Jaystonian/ClearVideo/vic20-svideoLHM/pics/vic20-svideoLHM.png

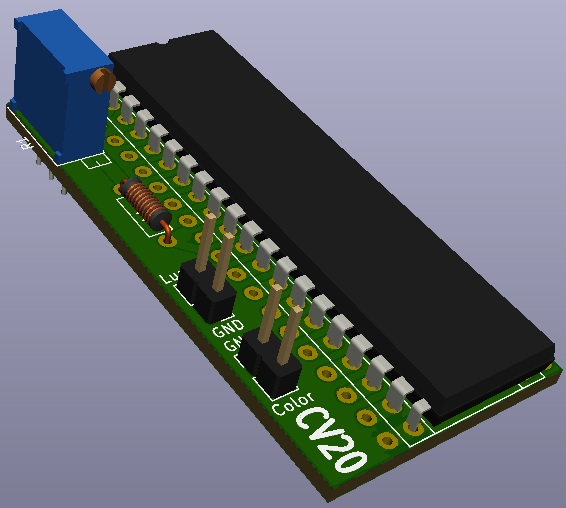
vic20-svideoLHM/pics/vic20-svideoLHM.png
