Jaystonian/ClearVideo/vic20-svideoLHM/pics/IMG_20200324_195534_3.jpg

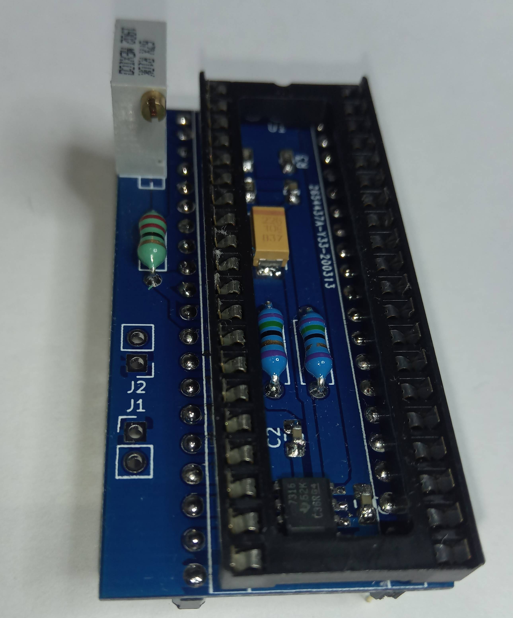
vic20-svideoLHM/pics/IMG_20200324_195534_3.jpg
