Jaystonian/ClearVideo/README.md

# ClearVideo
Various S-Video devices

2020-10-04 
 * Updated the schematics and pcb to show I am using a 74F04, not a 74F06.. It has always been a '04.
 * Updated CV128 layout slightly.
