Jaystonian/ClearVideo/clearvideo128/clearvideo128.jpg

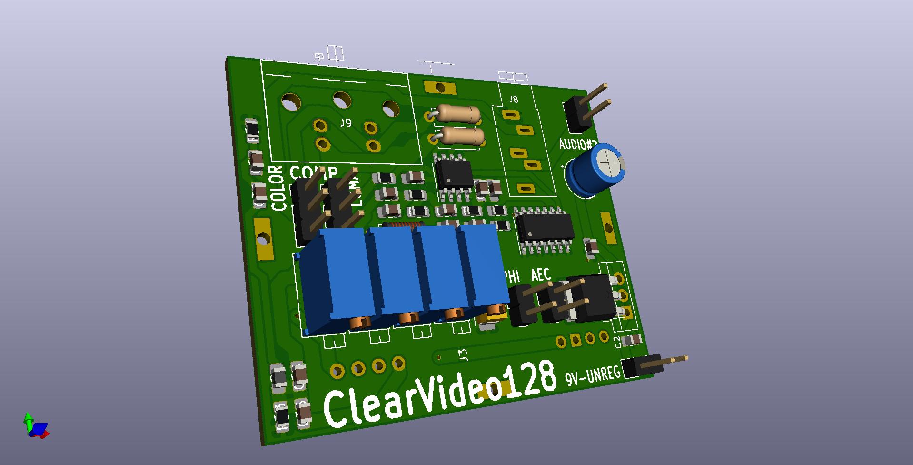
clearvideo128/clearvideo128.jpg
