Jaystonian/ClearVideo/vic20-svideoLHM/pics/IMG_20200324_195540_5.jpg

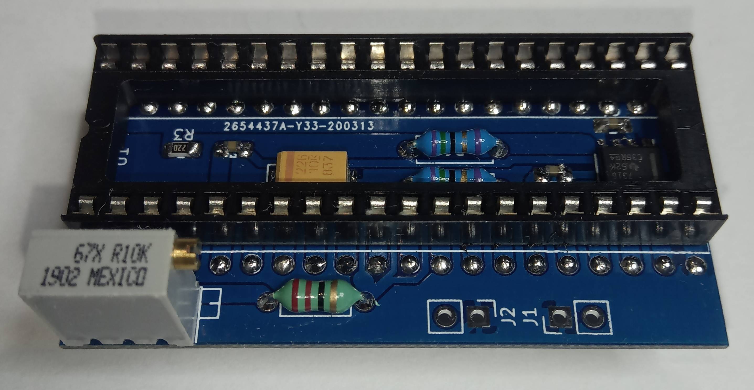
vic20-svideoLHM/pics/IMG_20200324_195540_5.jpg
