Jaystonian/ClearVideo/vic20-svideoLHM/pics/inst1.jpg

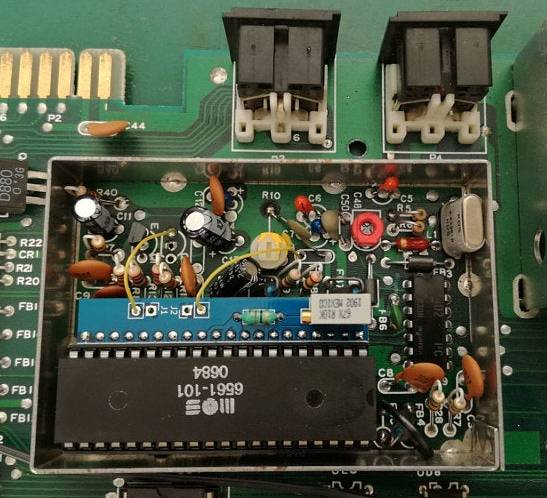
vic20-svideoLHM/pics/inst1.jpg
