Jaystonian/ClearVideo/vic20-svideoLHM/pics/inst2.jpg

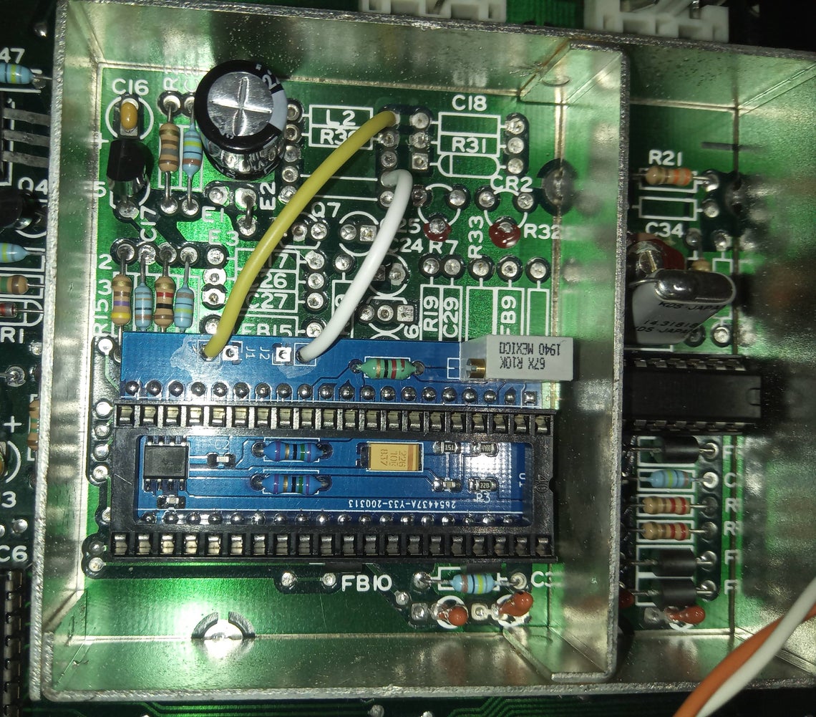
vic20-svideoLHM/pics/inst2.jpg
