Jaystonian/ClearVideo/vic20-svideoLHM/bom.txt

Most SMD are 2012 metric
22uF SMD is 6032 Kemet 

75.0R	0.302	2	r4,r7
THS7316D	0.852	1	u1
74LVC06	0.255	1	u2

R2	22R
R6	150R
R13	2K
R15	2K
R8	2K
R14	250R
R9	250R
R10	470R
R3	5K6

R16	250R
R1	10K

L1	22uH

C1	330pF
C2	150pF
C3	0.1uF
C4	0.1uF
C5	0.1uF
C6	47pF
C7	47pF
C8	22uF
C9	0.1uF
C11	47pF
