Jaystonian/ClearVideo/clearvideo128/clearvideo128.pdf

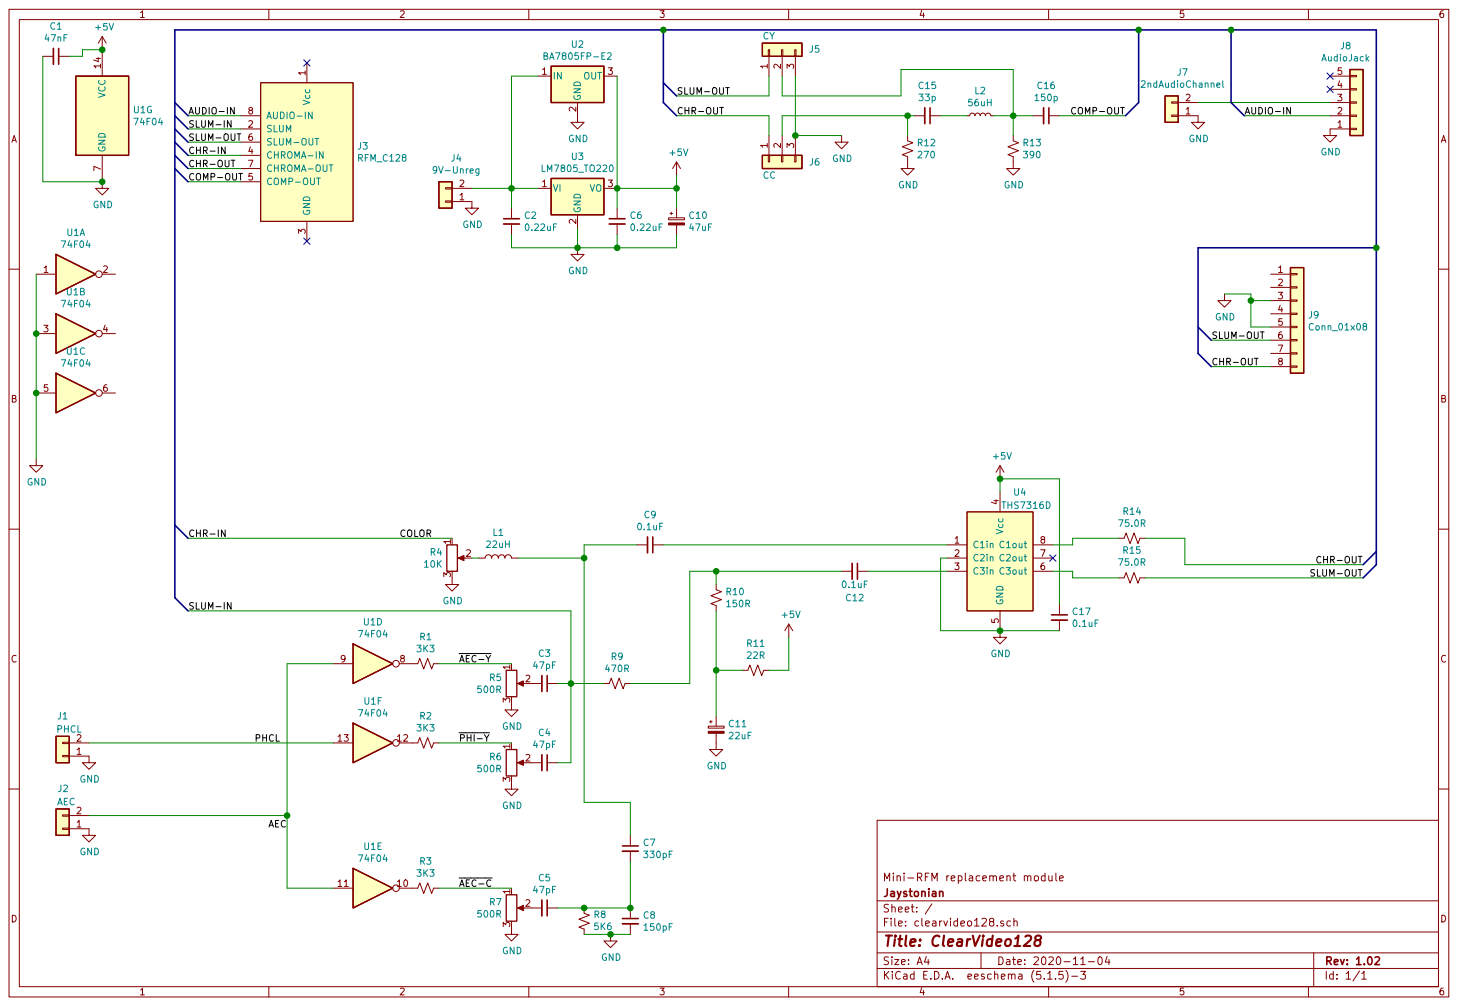
[picture p7: page 1]

SLUM-IN
SLUM-OUT CHR-IN
74F04 GND

3 CHROMA-IN 4 COMP-OUT 5 SLUM-OUT 6 CHROMA-OUT 7 AUDIO-IN 8

CHR-OUT PHCL AEC

CHR-OUT SLUM-OUT AEC-Y

Mini-RFM replacement module R8

File: clearvideo128.sch Sheet: / Jaystonian
