Jaystonian/ClearVideo/clearvideo128/clearvideo128.kicad_pcb

## KiCad design clearvideo128/clearvideo128.kicad_pcb (2020-10-06)

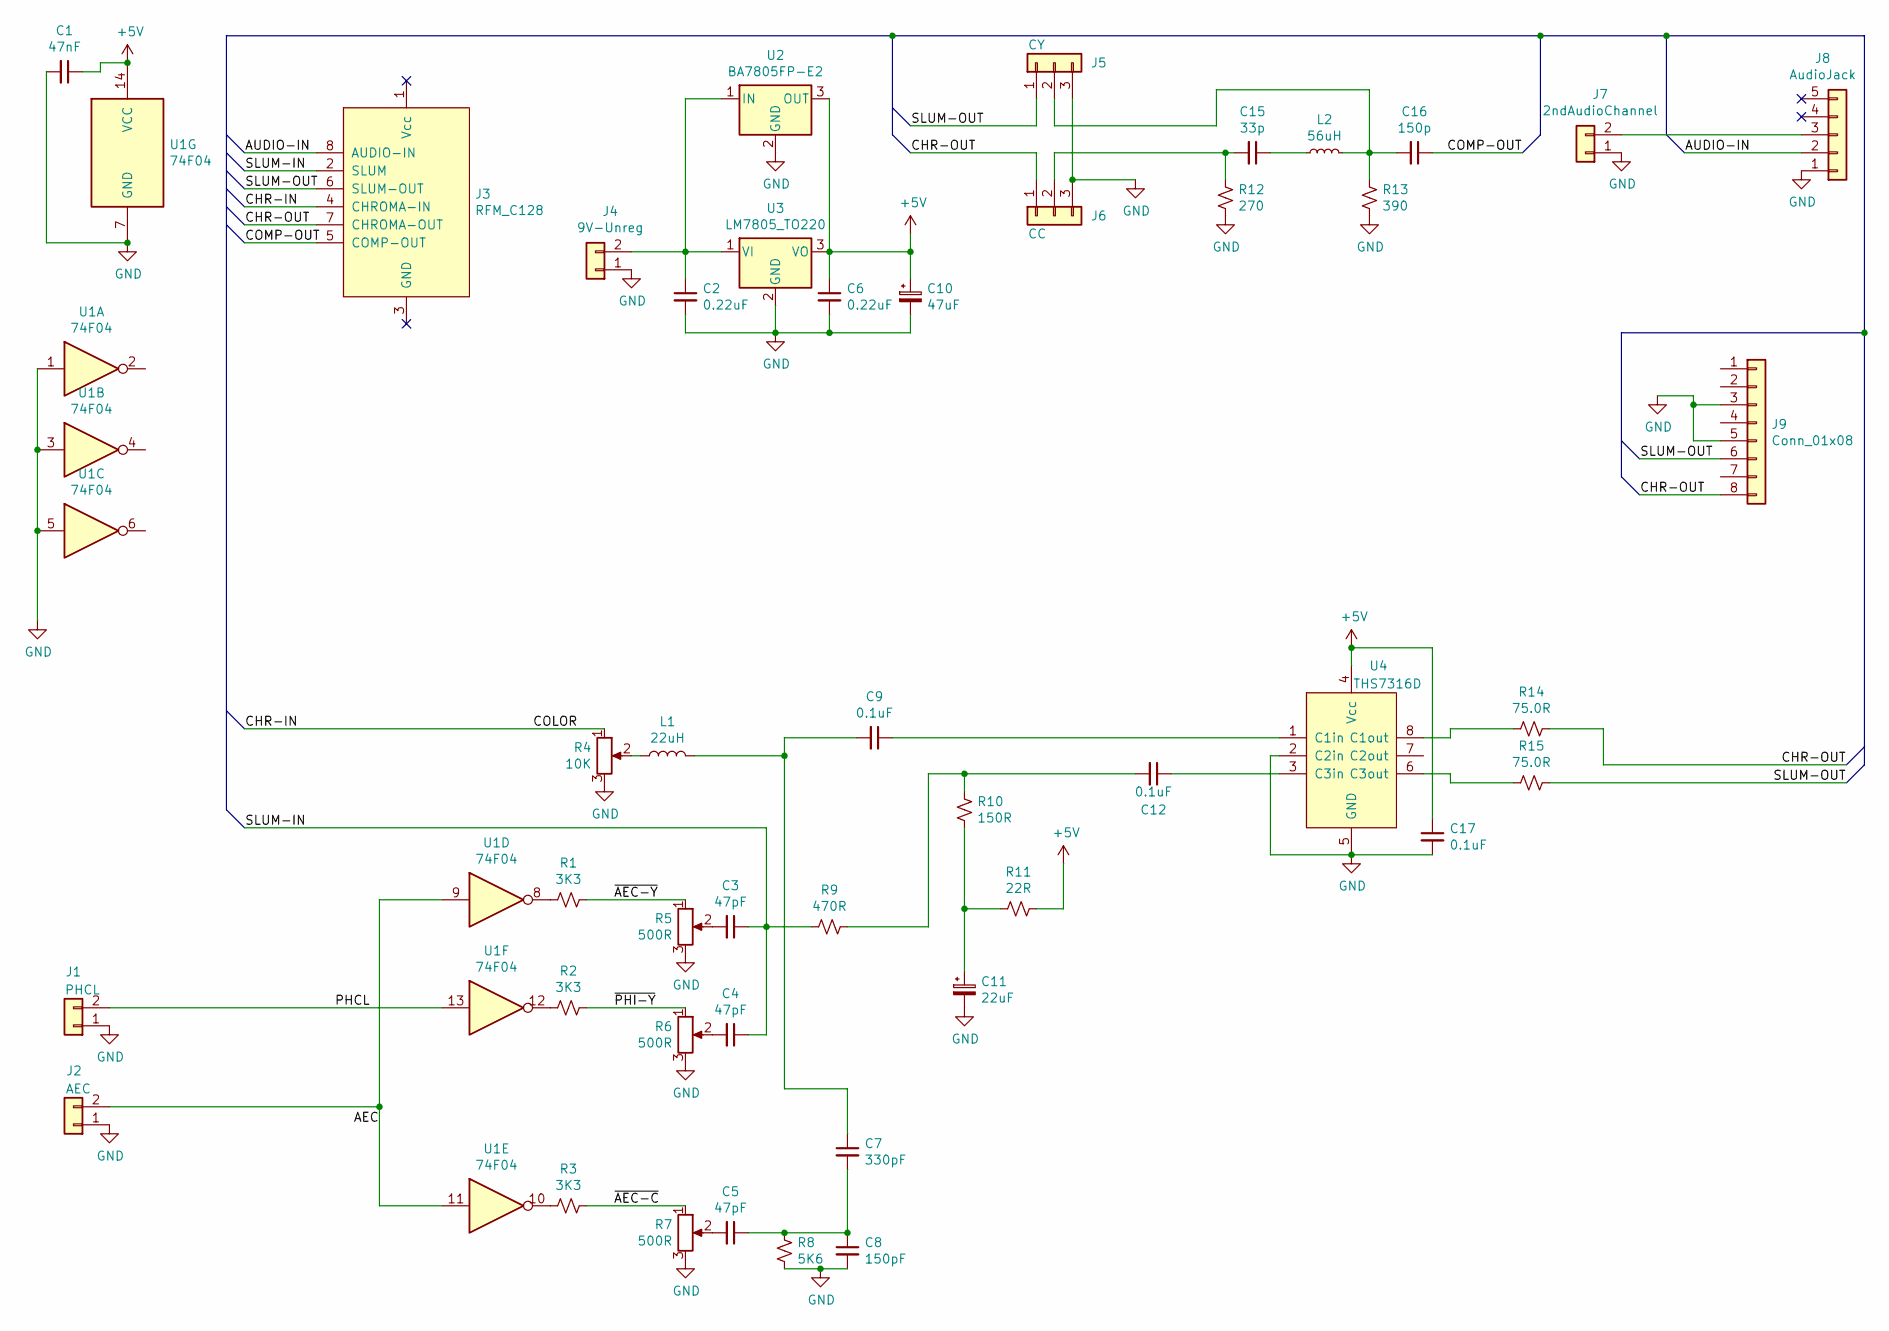
[picture p8: schematic clearvideo128.sch]

Parts:
C1: 47nF; C_0805_2012Metric_Pad1.15x1.40mm_HandSolder
C2, C6: 0.22uF; C_0805_2012Metric_Pad1.15x1.40mm_HandSolder
C3, C4, C5: 47pF; C_0805_2012Metric_Pad1.15x1.40mm_HandSolder
C7: 330pF; C_0805_2012Metric_Pad1.15x1.40mm_HandSolder
C8: 150pF; C_0805_2012Metric_Pad1.15x1.40mm_HandSolder
C9, C12, C17: 0.1uF; C_0805_2012Metric_Pad1.15x1.40mm_HandSolder
C10: 47uF; CP_Radial_D6.3mm_P2.50mm
C11: 22uF; CP_EIA-6032-28_Kemet-C_Pad2.25x2.35mm_HandSolder
C15: 33p; C_0805_2012Metric_Pad1.15x1.40mm_HandSolder
C16: 150p; C_0805_2012Metric_Pad1.15x1.40mm_HandSolder
J1: PHCL; PinHeader_1x02_P2.54mm_Vertical
J2: AEC; PinHeader_1x02_P2.54mm_Vertical
J3: RFM_C128
J4: 9V-Unreg; PinHeader_1x02_P2.54mm_Vertical
J5: CY; PinHeader_1x03_P2.54mm_Vertical
J6: CC; PinHeader_1x03_P2.54mm_Vertical
J7: 2ndAudioChannel; PinHeader_1x02_P2.54mm_Vertical
J8: AudioJack; Audio_SJ1-3535NG
J9: Conn_01x08; SVIDEO_PORT_KMDGX-4S-BS
L1: 22uH; L_Axial_L5.3mm_D2.2mm_P7.62mm_Horizontal_Vishay_IM-1
L2: 56uH; L_0805_2012Metric_Pad1.15x1.40mm_HandSolder
R1, R2, R3: 3K3; R_0805_2012Metric_Pad1.15x1.40mm_HandSolder
R4: 10K; Potentiometer_Bourns_3296X_Horizontal
R5, R6, R7: 500R; Potentiometer_Bourns_3296X_Horizontal
R8: 5K6; R_0805_2012Metric_Pad1.15x1.40mm_HandSolder
R9: 470R; R_0805_2012Metric_Pad1.15x1.40mm_HandSolder
R10: 150R; R_0805_2012Metric_Pad1.15x1.40mm_HandSolder
R11: 22R; R_0805_2012Metric_Pad1.15x1.40mm_HandSolder
R12: 270; R_0805_2012Metric_Pad1.15x1.40mm_HandSolder
R13: 390; R_0805_2012Metric_Pad1.15x1.40mm_HandSolder
R14, R15: 75.0R; R_Axial_DIN0207_L6.3mm_D2.5mm_P7.62mm_Horizontal
U1: 74F04; SOIC-14_3.9x8.7mm_P1.27mm
U2: BA7805FP-E2; TO-252-3_TabPin2
U3: LM7805_TO220; TO-220-3_Vertical
U4: THS7316D; SO-8_3.9x4.9mm_P1.27mm

Connections:
+5V: C1.1, C6.1, C10.1, C17.1, R11.1, U1.14 (VCC), U2.3 (OUT), U3.3 (VO), U4.4 (Vcc)
/AEC: J2.2, U1.9, U1.11; also elsewhere on the board
/AUDIO-IN: J3.8 (AUDIO-IN), J8.2
/CHR-IN: J3.4 (CHROMA-IN), R4.1
/CHR-OUT: J3.7 (CHROMA-OUT), J6.1, J9.8, R14.1
/COMP-OUT: C16.1, J3.5 (COMP-OUT)
/PHCL: J1.2, U1.13; also elsewhere on the board
/SLUM-IN: C3.1, C4.1, J3.2 (SLUM), R9.2
/SLUM-OUT: J3.6 (SLUM-OUT), J5.1, J9.6, R15.2
/~AEC-C: R3.1, R7.1
/~AEC-Y: R1.1, R5.1
/~PHI-Y: R2.1, R6.1
GND: C1.2, C2.2, C6.2, C8.2, C10.2, C11.2, C17.2, J1.1, J2.1, J4.1, J5.3, J6.3, J7.1, J8.1, J9.3, J9.5, R4.3, R5.3, R6.3, R7.3, R8.1, R12.2, R13.2, U1.1, U1.3, U1.5, U1.7 (GND), U2.2 (GND), U3.2 (GND), U4.2 (C2in), U4.5 (GND); also elsewhere on the board
unnamed 13: C2.1, J4.2, U2.1 (IN), U3.1 (VI); also elsewhere on the board
unnamed: C3.2, R5.2
unnamed: C4.2, R6.2
unnamed: C5.1, C7.2, C8.1, R8.2
unnamed: C5.2, R7.2
unnamed: C7.1, C9.2, L1.2
unnamed: C9.1, U4.1 (C1in)
unnamed: C11.1, R10.2, R11.2
unnamed: C12.1, U4.3 (C3in)
unnamed: C12.2, R9.1, R10.1
unnamed: C15.1, L2.1
unnamed: C15.2, J6.2, R12.1
unnamed: C16.2, J5.2, L2.2, R13.1
unnamed 28: J7.2, J8.3; also elsewhere on the board
unnamed: L1.1, R4.2
unnamed: R1.2, U1.8
unnamed: R2.2, U1.12
unnamed: R3.2, U1.10
unnamed: R14.2, U4.8 (C1out)
unnamed: R15.1, U4.6 (C3out)

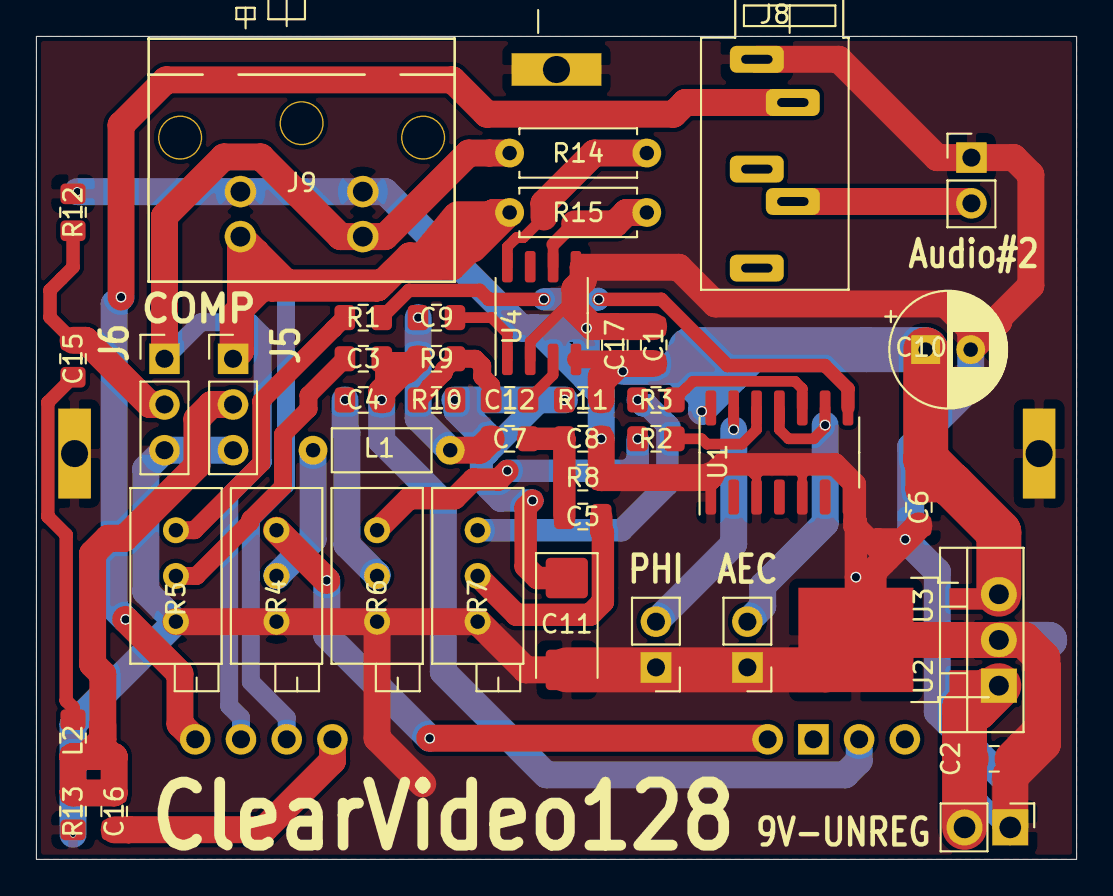
[picture p9: board clearvideo128.kicad_pcb from above]

Board: 2 copper layers, 57.8 x 45.7 mm, 45 parts (0 on the bottom side), 33 nets.

Other parts of the board:
9V-UNREG: 9V-Unreg; PinHeader_1x02_P2.54mm_Vertical
AEC: AEC; PinHeader_1x02_P2.54mm_Vertical
Audio#2: 2ndAudioChannel; PinHeader_1x02_P2.54mm_Vertical
PHI: PHCL; PinHeader_1x02_P2.54mm_Vertical

Their connections:
/AEC: AEC.2; also elsewhere on the board
/PHCL: PHI.2; also elsewhere on the board
GND: 9V-UNREG.1, AEC.1, Audio#2.1, PHI.1; also elsewhere on the board
unnamed 13: 9V-UNREG.2; also elsewhere on the board
unnamed 28: Audio#2.2; also elsewhere on the board
