Jaystonian/ClearVideo/clearvideo64/clearvideo64.kicad_pcb

## KiCad design clearvideo64/clearvideo64.kicad_pcb (2020-10-06)

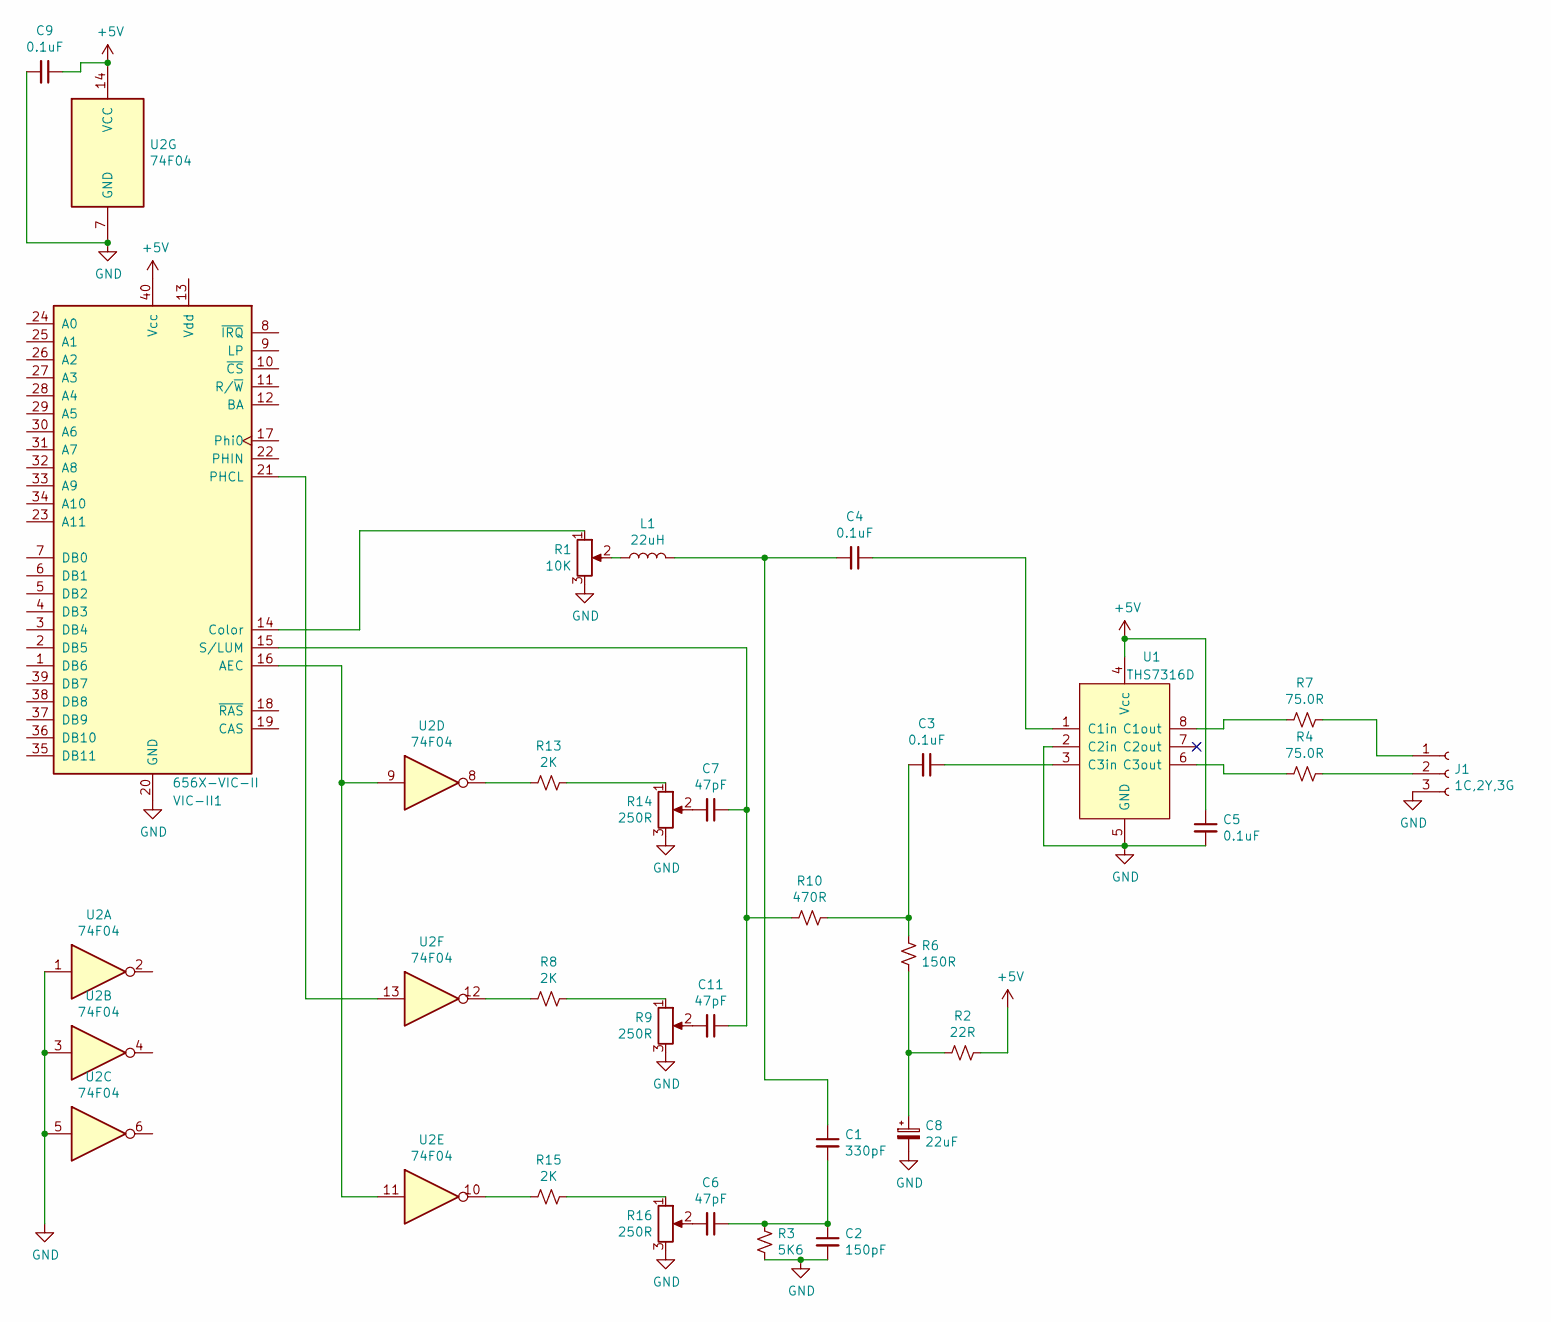
[picture p10: schematic clearvideo64.sch]

Parts:
C1: 330pF; C_0805_2012Metric_Pad1.15x1.40mm_HandSolder
C2: 150pF; C_0805_2012Metric_Pad1.15x1.40mm_HandSolder
C3, C4, C5, C9: 0.1uF; C_0805_2012Metric_Pad1.15x1.40mm_HandSolder
C6, C7, C11: 47pF; C_0805_2012Metric_Pad1.15x1.40mm_HandSolder
C8: 22uF; CP_EIA-6032-28_Kemet-C_Pad2.25x2.35mm_HandSolder
J1: 1C,2Y,3G; VideoOutHeader_1x03
L1: 22uH; L_Axial_L5.3mm_D2.2mm_P7.62mm_Horizontal_Vishay_IM-1
R1: 10K; Potentiometer_Bourns_3296X_Horizontal
R2: 22R; R_0805_2012Metric_Pad1.15x1.40mm_HandSolder
R3: 5K6; R_0805_2012Metric_Pad1.15x1.40mm_HandSolder
R4, R7: 75.0R; R_Axial_DIN0207_L6.3mm_D2.5mm_P7.62mm_Horizontal
R6: 150R; R_0805_2012Metric_Pad1.15x1.40mm_HandSolder
R8, R13, R15: 2K; R_0805_2012Metric_Pad1.15x1.40mm_HandSolder
R9, R14, R16: 250R; Potentiometer_Bourns_3296X_Horizontal
R10: 470R; R_0805_2012Metric_Pad1.15x1.40mm_HandSolder
U1: THS7316D; SO-8_3.9x4.9mm_P1.27mm
U2: 74F04; SOIC-14_3.9x8.7mm_P1.27mm
VIC-II1: 656X-VIC-II; DIP-40_W15.24mm

Connections:
+5V: C5.1, C9.1, R2.1, U1.4 (Vcc), U2.14 (VCC), VIC-II1.40 (Vcc)
GND: C2.2, C5.2, C8.2, C9.2, J1.3, R1.3, R3.1, R9.3, R14.3, R16.3, U1.2 (C2in), U1.5 (GND), U2.1, U2.3, U2.5, U2.7 (GND), VIC-II1.20 (GND)
unnamed: C1.1, C4.2, L1.2
unnamed: C1.2, C2.1, C6.1, R3.2
unnamed: C3.1, U1.3 (C3in)
unnamed: C3.2, R6.1, R10.1
unnamed: C4.1, U1.1 (C1in)
unnamed: C6.2, R16.2
unnamed: C7.2, R14.2
unnamed: C8.1, R2.2, R6.2
unnamed: C7.1, C11.1, R10.2, VIC-II1.15 (S/LUM)
unnamed: C11.2, R9.2
unnamed: J1.1, R7.1
unnamed: J1.2, R4.2
unnamed: L1.1, R1.2
unnamed: R1.1, VIC-II1.14 (Color)
unnamed: R4.1, U1.6 (C3out)
unnamed: R7.2, U1.8 (C1out)
unnamed: R8.1, R9.1
unnamed: R8.2, U2.12
unnamed: R13.1, R14.1
unnamed: R13.2, U2.8
unnamed: R15.1, R16.1
unnamed: R15.2, U2.10
unnamed: U2.9, U2.11, VIC-II1.16 (AEC)
unnamed: U2.13, VIC-II1.21 (PHCL)

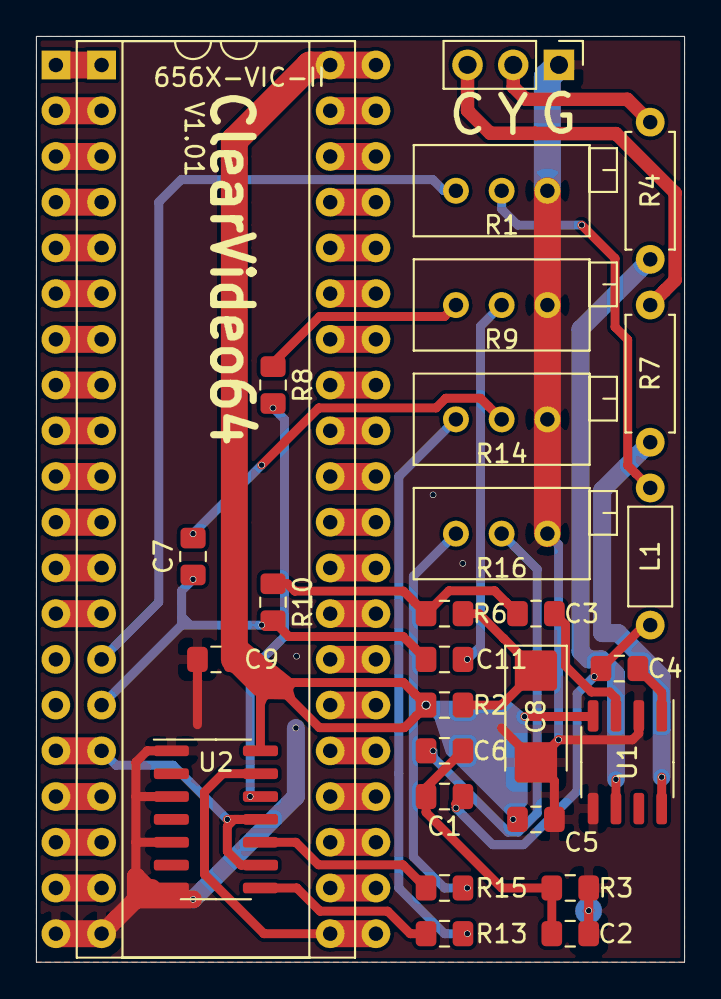
[picture p11: board clearvideo64.kicad_pcb from above]

Board: 2 copper layers, 36.0 x 51.4 mm, 28 parts (0 on the bottom side), 26 nets.
