Jaystonian/ClearVideo/vic20-svideoLHM/vic20-svideoLHM.kicad_pcb

## KiCad design vic20-svideoLHM/vic20-svideoLHM.kicad_pcb (2020-08-12)

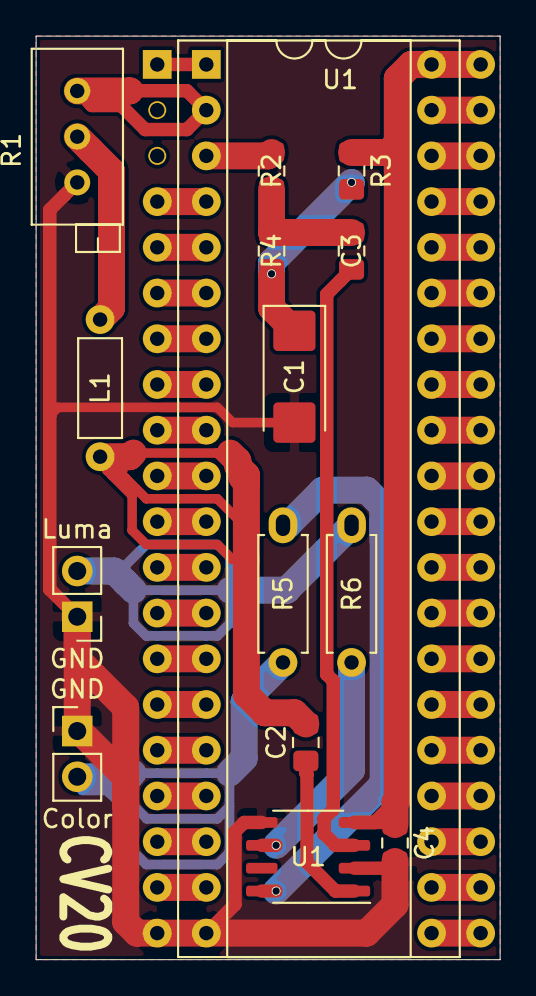
[picture p12: board vic20-svideoLHM.kicad_pcb from above]

Board: 2 copper layers, 25.8 x 51.3 mm, 16 parts (0 on the bottom side), 50 nets.

Parts:
C1: 22uF; CP_EIA-6032-28_Kemet-C_Pad2.25x2.35mm_HandSolder
C2, C3, C4: 0.1uF; C_0805_2012Metric_Pad1.15x1.40mm_HandSolder
GND: Color; PinHeader_1x02_P2.54mm_Vertical
GND#2: Luma; PinHeader_1x02_P2.54mm_Vertical
L1: 22uH; L_Axial_L5.3mm_D2.2mm_P7.62mm_Horizontal_Vishay_IM-1
R1: 10K; Potentiometer_Bourns_3296X_Horizontal
R2: 470R; R_0805_2012Metric_Pad1.15x1.40mm_HandSolder
R3: 22R; R_0805_2012Metric_Pad1.15x1.40mm_HandSolder
R4: 150R; R_0805_2012Metric_Pad1.15x1.40mm_HandSolder
R5, R6: 75.0R; R_Axial_DIN0207_L6.3mm_D2.5mm_P7.62mm_Horizontal
U1: THS7316D; SO-8_3.9x4.9mm_P1.27mm
U1#2: 656X-VIC-I; DIP-40_W15.24mm
U-SOCKET1: 656X-VIC-I; DIP-40_W15.24mm

Connections:
+5V: C4.1, R3.1, U1.4, U1#2.40, U-SOCKET1.40
/A0: U1#2.21, U-SOCKET1.21
/A1: U1#2.22, U-SOCKET1.22
/A2: U1#2.23, U-SOCKET1.23
/A3: U1#2.24, U-SOCKET1.24
/A4: U1#2.25, U-SOCKET1.25
/A5: U1#2.26, U-SOCKET1.26
/A6: U1#2.27, U-SOCKET1.27
/A7: U1#2.28, U-SOCKET1.28
/A8: U1#2.29, U-SOCKET1.29
/A9: U1#2.30, U-SOCKET1.30
/A10: U1#2.31, U-SOCKET1.31
/A11: U1#2.32, U-SOCKET1.32
/A12: U1#2.33, U-SOCKET1.33
/A13: U1#2.34, U-SOCKET1.34
/Audio: U1#2.19, U-SOCKET1.19
/Color: R1.1, U1#2.2
/D0: U1#2.16, U-SOCKET1.16
/D1: U1#2.15, U-SOCKET1.15
/D2: U1#2.14, U-SOCKET1.14
/D3: U1#2.13, U-SOCKET1.13
/D4: U1#2.12, U-SOCKET1.12
/D5: U1#2.11, U-SOCKET1.11
/D6: U1#2.10, U-SOCKET1.10
/D7: U1#2.9, U-SOCKET1.9
/D8: U1#2.8, U-SOCKET1.8
/D9: U1#2.7, U-SOCKET1.7
/D10: U1#2.6, U-SOCKET1.6
/D11: U1#2.5, U-SOCKET1.5
/Luma: R2.2, U1#2.3
/NC: U1#2.1, U-SOCKET1.1
/Option: U1#2.37, U-SOCKET1.37
/PPhi1: U1#2.35, U-SOCKET1.35
/PPhi2: U1#2.36, U-SOCKET1.36
/Phi1: U1#2.39, U-SOCKET1.39
/Phi2: U1#2.38, U-SOCKET1.38
/PotX: U1#2.17, U-SOCKET1.17
/PotY: U1#2.18, U-SOCKET1.18
/R~W~: U1#2.4, U-SOCKET1.4
GND: C1.2, C4.2, GND.1, GND#2.1, R1.3, U1.2, U1.5, U1#2.20, U-SOCKET1.20
unnamed: C1.1, R3.2, R4.2
unnamed: C2.1, U1.1
unnamed: C2.2, L1.2
unnamed: C3.1, U1.3
unnamed: C3.2, R2.1, R4.1
unnamed: GND.2, R5.1
unnamed: GND#2.2, R6.2
unnamed: L1.1, R1.2
unnamed: R5.2, U1.8
unnamed: R6.1, U1.6
