Jaystonian/ClearVideo/(threads)

Thread 4 (2023-12-30):

Problem

Vintanerd, 2023-12-30:
Hi, I have a problem with my C128.
If I connect PHCL and AEC I get several thin vertical lines on the final screen.
Maybe a problem of this VICIIe?
Thanks

Jaystonian, 2025-04-04:
Sorry for the late reply, I didn't get a notification about this.  It should be PHI-1MHz, not PHCL.  The PHCL was a silkscreen error.  Instructions state to use Phi.
